vlaate/EqRADrive/(threads)

Thread 1 (2021-04-21):

Shaft coupling

Dark-wolf-29, 2021-04-21:
I  used a CNC shaft coupler to connect the motor shaft and the ra axis shaft but it doesnt connect.
